HWB-hub/UAV-Air-Drop-System/media/photos/微信图片_20261011125443_73_13.jpg

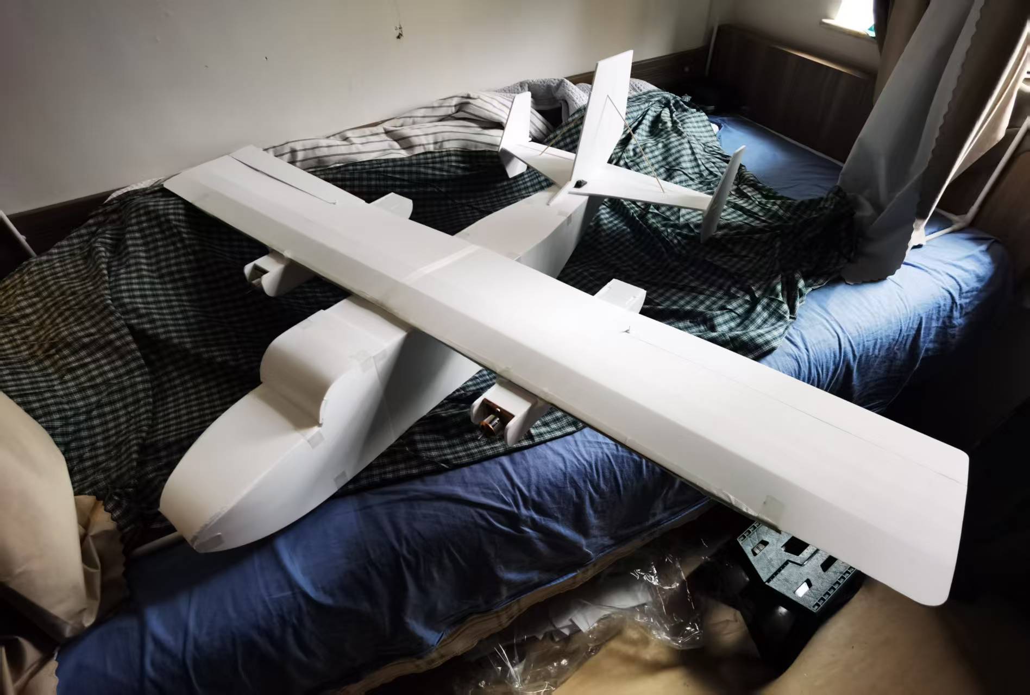
media/photos/微信图片_20261011125443_73_13.jpg
