HWB-hub/UAV-Air-Drop-System/README.md

**简体中文** | [English](README.en.md)

# 两轮卫星车投放与回收系统

**Two-Wheeled Rover Deployment & Recovery System**

一套完整的 **投放 → 伞降 → 回收 → 落地继续作业** 演示系统：自制固定翼无人机把一台 3D 打印的
**两轮卫星车（Rover）** 带到约 50 m 高空投放；卫星车靠**舵机触发的降落伞**安全落地；
落地后还能用**蓝牙遥控行驶**，并持续回传温度、气压、姿态数据。

| | |
|---|---|
| **项目定位** | 在业余预算下模拟真实卫星「发射 → 部署 → 下降 → 回收 → 继续工作」的全流程 |
| **我们做了什么** | ① 两轮卫星车：结构设计 + 3D 打印 + 电路 + 固件 + 伞舱释放机构 ② 固定翼载机的机体、动力与飞控 ③ 全部地面 / 空中测试与数据分析 |
| **关键指标** | 伞舱释放机构成本约为电磁锁方案的 1/10（约 $2 vs $20）· 载荷比 1:4 · 投放横向精度 ±1.5 m · 重复投放零损坏 |
| **团队** | 黄文博 · 孔筱崧 · Alexander He Wu · 马天辰 |

---

## 目录

1. [这个系统是什么](#1-这个系统是什么)
2. [我们做了什么](#2-我们做了什么)
   - [2.1 卫星车 · 机械结构](#21-卫星车--机械结构)
   - [2.2 卫星车 · 伞舱释放机构（核心创新）](#22-卫星车--伞舱释放机构核心创新)
   - [2.3 卫星车 · 电路与硬件](#23-卫星车--电路与硬件)
   - [2.4 卫星车 · 固件与通信协议](#24-卫星车--固件与通信协议)
   - [2.5 无线方案迭代：为什么最终用蓝牙而不是 XBee](#25-无线方案迭代为什么最终用蓝牙而不是-xbee)
   - [2.6 固定翼载机](#26-固定翼载机)
   - [2.7 测试与实测数据](#27-测试与实测数据)
   - [2.8 遇到的问题与解决办法](#28-遇到的问题与解决办法)
   - [2.9 预算](#29-预算)
3. [仓库结构](#3-仓库结构)
4. [快速上手（怎么把卫星车跑起来）](#4-快速上手怎么把卫星车跑起来)
5. [许可与团队](#5-许可与团队)

---

## 1. 这个系统是什么

把它想成一个**缩小的卫星任务**：真实的卫星要由火箭送到轨道、在轨分离、再入并回收；我们用一架
固定翼无人机代替火箭、用一台两轮小车代替卫星载荷，把这条链路完整地做了一遍，并且**落地之后
载荷还能继续工作**。

整条任务链分四步：

```text
  +-------------+ 舵机开舱门（遥控器 6 通道）    +----------------------+
  |  固定翼载机  |                              |    卫星车从机腹弹出   |
  |  （无人机）  | ------------------------->   |     高度约 50 m      |
  +-------------+                              +-----------+----------+
                                                           |
                                                           |  弹出后继续前冲
                                                           v
                                   +----------------------------------------------+
                                   |           伞舱释放（舵机 + 铁杆插销）          |
                                   |          铁杆抽出 -> 尼龙绳脱开 -> 开伞        |
                                   +-----------------------+----------------------+
                                                           |
                                                           v
                                   +----------------------------------------------+
                                   |              稳定下降 -> 安全着陆             |
                                   |           （30 m / 1.5 m 投放试验）           |
                                   +-----------------------+----------------------+
                                                           |
                                                           v
                                   +----------------------------------------------+
                                   |    落地后：蓝牙 HC-05 遥控行驶（F/B/L/R/S）    |
                                   |    并持续回传 MPU6050 / DPS310 / LM35 数据    |
                                   +----------------------------------------------+
```

1. **挂载**：卫星车被固定在载机的舱内，随飞机爬升到投放高度。
2. **投放**：飞手拨动遥控器第 6 通道，舵机打开舱门，卫星车被抛出。
3. **下降**：伞舱释放机构触发（见 [2.2](#22-卫星车--伞舱释放机构核心创新)），降落伞张开，卫星车稳定落地。
4. **回收与作业**：着陆后卫星车测量环境参数，并可由蓝牙遥控行驶，完成「回收后继续执行任务」这一环。

## 2. 我们做了什么

### 2.1 卫星车 · 机械结构

车体在 **Autodesk Fusion 360** 中建模、**3D 打印**成型。最终材料为 **PETG**，填充率 **30%**
（早期原型用陶瓷树脂、层高 0.3 mm；早期投放试验出现开裂后，改用 PETG 并把填充率提到 30% 以吸收冲击）。

打印壳体的几个设计要点：

* **两侧轮舱**按 N20 电机的轴距设计，并留出电机驱动与电池的**散热通风孔**。
* **传感器凹槽**按 **±0.2 mm** 公差开槽固定 MPU6050 与 DPS310，保证不同批次装配后测量轴一致。
* **舵机支架**竖直安装在壳体顶部，通过焊接铁杆连接到插销卡槽；静态测试中插销可拉住 **50 g** 后才脱开。
* **两个 40 mm 橡胶胎面车轮**，配合**差速（滑移）转向**，可爬 **15°** 坡、可原地转向，不需要转向舵机。
* **抗冲击**：结构通过 **10 次 1 m 自由落体**测试，壳体未开裂、传感器未位移；30 m / 1.5 m 伞降试验**零损坏**。
* 底部加一块**玻纤底板**增加刚度，并作为电路板与电池的安装面。

> 🖼️ 各元件的 Fusion 360 参考模型（Nano、MPU6050、车轮、N20 电机、电池、万用板、舵机、XBee、电机控制模块）
> 见 [`rover/cad/fusion360_components/`](rover/cad/fusion360_components/)。

### 2.2 卫星车 · 伞舱释放机构（核心创新）

这是整个卫星车最有特色的一块：**用一颗微型舵机 + 一根铁杆插销，替代了常见的电磁锁**，
把成本与电路复杂度几乎全部省掉。

```text
   降落伞尼龙绳（绳环）
           |
           v
  +-----------------+
  |    舵机摇臂     |   铁杆穿过绳环，
  |   (SG90, D3)    |--> 由自制卡槽固定住
  +--------+--------+
           |  舵机转过 90°（蓝牙发送 "U" 指令）
           v
  +-----------------+
  |   铁杆被抽回    |--> 绳环脱开，降落伞自由
  +-----------------+
           |  相对气流 / 卫星车惯性把伞带出
           v
        降落伞张开
```

工作过程：

1. 一根**系留铁杆**固定在 SG90 舵机摇臂上，并由一块自制卡槽锁住；铁杆**穿过降落伞尼龙绳上的绳环**，
   把折叠好的降落伞**扣住**。
2. 需要开伞时，Arduino 让舵机转过 **90°**（蓝牙发 `U`），摇臂旋转、**铁杆从绳环中抽出**。
3. 降落伞此时已自由，卫星车继续飞行，伞被**相对气流 / 惯性**拉出并充气张开——
   不需要火工品、不需要弹簧、不需要额外执行器。

选这个方案的理由：

| 指标 | 电磁锁方案 | 舵机 + 铁杆（本项目） |
|---|---|---|
| 器件成本 | 约 $20 | **约 $2（降低约 90%）** |
| 需要额外电路 | 驱动电路 + 锁扣线圈 | 不需要，一颗普通舵机、直接接 Arduino |
| 可靠性（试验） | — | 30 m / 1.5 m 投放试验约 98% 成功开伞 |
| 失效表现 | 卡扣卡死 / 线圈过热 | 舵机堵转 → 复位即可；伞始终被扣住（偏安全） |

### 2.3 卫星车 · 电路与硬件

主控是 **Arduino Nano（ATmega328P）**。两个 **N20 减速电机**由 **TB6612FNG 双 H 桥**驱动，
两路驱动分别接到 **4 个数字口**（IN1/IN2 + IN3/IN4），因此左右轮可各自正反转，实现差速转向。
电机供电直接从 **7.4 V（2S）锂聚合物电池**取，避免大电流干扰逻辑电源。

最终固件（`rover_hc05_bluetooth_FINAL`）的接线：

| 功能 | 引脚 | 说明 |
|---|---|---|
| 电机 A（左）IN1 / IN2 | **D4 / D5** | 接 TB6612FNG Motor A |
| 电机 B（右）IN3 / IN4 | **D6 / D8** | 接 TB6612FNG Motor B |
| 降落伞 SG90 舵机（信号） | **D3** | PWM，0° → 90° 即释放 |
| LM35DZ（模拟温度） | **A2** | 10 mV/°C，`V = 采样值×5/1023`，`T = V×100` |
| MPU6050（I²C） | **A4 (SDA) / A5 (SCL)** | 地址 `0x68`，原始值 /16384（加速度）、/131（陀螺仪） |
| DPS310 气压计 | **SPI，CS = D10** | `dps.begin_SPI(10)`（Adafruit_DPS310） |
| HC-05 蓝牙 | **D0 (RX) / D1 (TX)** | 硬件串口，9600 波特率 |
| 串口调试 | USB | 同一路 9600 串口输出 |

**电源可行性估算（电子部分最坏情况电流预算）：**

| 器件 | 电流 |
|---|---|
| MPU6050 | 5 mA |
| BMP280 | 5 mA |
| LM35DZ | 5 mA |
| XBee-PRO S1 | 50 mA |
| TB6612FNG | 10 mA |
| Arduino Nano | 50 mA |
| N20 减速电机 ×2 | 各 150 mA |
| **合计** | **约 475 mA** |

这个估算确认了 7.4 V（2S）锂电池 + 5 V 稳压足以稳定供给整块电路板。

### 2.4 卫星车 · 固件与通信协议

全部 Arduino 代码在 [`rover/firmware/`](rover/firmware/)。每个文件夹都是一个**独立的 Arduino
工程**：用 Arduino IDE 打开 `.ino`，板子选 **Arduino Nano / ATmega328P**，通过 USB 下载即可。

| 工程 | 状态 | 通信方式 | 说明 |
|---|---|---|---|
| `rover_hc05_bluetooth_FINAL` | ✅ **最终版，现场投放使用的就是它** | HC-05 蓝牙，硬件串口 D0/D1 | 传感器采集 + 遥测输出 + 电机控制 + 伞舱舵机指令 |
| `xbee_rover_enddevice_swserial` | ⚙️ 早期（XBee） | XBee 接软串口 D2/D3 | 卫星车作为 XBee 终端节点，数据经电台转发 |
| `xbee_rover_enddevice_hwserial` | ⚙️ 早期（XBee） | XBee 接硬件串口 | 终端节点变体（增加了打印 NaN 的保护） |
| `xbee_ground_coordinator` | ⚙️ 早期（XBee） | XBee 接软串口 D2/D3 | 地面站协调器：接收遥测、把键盘指令转发给卫星车 |
| `xbee_ground_coordinator_dev` | ⚙️ 开发迭代 | 同上 | 协调器变体（转发前会去掉 CR/LF） |
| `component_tests/*` | 🧪 元件测试 | USB 串口 | BMP280 / DPS310 / LM35DZ / MPU6050 单器件测试程序 |

**遥测帧**（约每秒 1 帧，从 HC-05 串口 / USB 输出，9600 波特率）：

```text
T:<°C>,P:<hPa>,AX:<g>,AY:<g>,AZ:<g>,GX:<°/s>,GY:<°/s>,GZ:<°/s>,MPU Temp:<°C>
```

**行驶 / 开伞指令**——卫星车在 `handleCommand()` 里读取**单个 ASCII 字符**，
用任意蓝牙串口 App 连上 HC-05 即可发送：

| 字符 | 效果（最终固件） |
|---|---|
| `F` | 前进 —— 两个电机同向驱动 |
| `B` | 后退 —— 两个电机反向驱动 |
| `L` | 原地左转 —— 左轮反转、右轮正转 |
| `R` | 原地右转 —— 左轮正转、右轮反转 |
| `S` | 两轮停转，同时把伞舱舵机归位到 0° |
| `U` | 舵机转到 90° → **释放降落伞** |

### 2.5 无线方案迭代：为什么最终用蓝牙而不是 XBee

第一版无线方案用的是 **XBee-PRO S1** 数传电台（配一块地面协调器板），但实测中 XBee 节点
**在休眠/唤醒时不稳定**，而且在现场测试里**会丢接收到的射频数据**，于是换成了 **蓝牙 HC-05**
（手机直接配对，不再需要单独的地面协调器硬件）。

| | XBee 方案（早期） | 蓝牙方案（最终） |
|---|---|---|
| 无线模块 | **XBee-PRO S1** ↔ 地面协调器 | **HC-05** ↔ 手机串口 App |
| 气压计 | **BMP280** | **DPS310**（精度更高） |
| 现场表现 | ❌ 休眠/唤醒不稳定，测试中丢射频数据 | ✅ 稳定，指令延迟 < 0.5 s |
| 地面站 | 需要单独的协调器板 + 电脑 | 不需要，手机直接配对 |

### 2.6 固定翼载机

载机是一架自制固定翼飞机：机体用 **PP（魔术）板**激光切割成型、电子胶粘接，机翼与机身用
**碳纤维杆**加强，控制连杆为钢丝推杆。动力与航电部分：

| 部件 | 规格 / 作用 |
|---|---|
| **A2212 KV1400** 无刷电机 | 2–3S，约 47 g，3.17 mm 轴 |
| **40 A 电调 ×2** | 双发动力、差速推力 |
| **4S 2200 mAh 45C 锂电池** | 主电源 |
| **RF209S 九通道接收机** | PWM / PPM / S.BUS 输出 |
| **舵机 ×7** | 副翼（2）、升降舵、方向舵、舱门等 |
| **PID 飞控** | 电脑端预调参，提供增稳辅助 |

投放任务用到的接收机通道映射：

| 通道 | 用途 |
|---|---|
| Ch1 | 副翼舵机 ×2（并联） |
| Ch2 | 升降舵 |
| Ch3 & Ch5 | 双电调（差速推力） |
| Ch4 | 方向舵 |
| **Ch6** | **舱门 —— 投放卫星车** |
| **Ch9** | PID 飞控开关 |

飞手拨动 Ch6 打开舱门，卫星车在约 50 m 高度被投放，随后进入伞降回收流程。

### 2.7 测试与实测数据

* **投放 / 回收**：30 m 与 1.5 m 两种投放试验，开伞可靠（约 98%），PETG 壳体无破损，重复投放**零损坏**。
* **投放精度**：从约 50 m 高度投放，横向落点精度 **±1.5 m**；载机载荷比 **1:4**。
* **传感器**：
  * MPU6050：加速度 ±2 g（±0.05 g）、陀螺仪 ±250 °/s（±3%）；现场数据里开伞瞬间 Z 轴加速度约变化 1.5 g。
  * DPS310：量程 300–1200 hPa（±1 hPa），标定的高度误差 **±1.5 m**（融合后约 ±1.2 m）；地面输出稳定在约 1011 hPa。
  * LM35DZ：现场实测稳定工作在 −10 … +40 °C 区间。
* **通信**：HC-05 指令延迟 **< 0.5 s**（实测约 0.3 s 内响应），卫星车 ↔ 地面站链路端到端验证通过。

### 2.8 遇到的问题与解决办法

| 问题 | 根本原因 | 解决办法 |
|---|---|---|
| 蓝牙信号丢失 | 电机线缆的电磁干扰 | 电机线加屏蔽 + HC-05 上套磁环 |
| 低温下传感器数据漂移 | LM35 噪声 | LM35 输出端并联 0.1 µF 电容 |
| 壳体开裂 | 3D 打印层间结合强度不足 | 填充率提到 30% + 换 PETG 材料 |
| 电池过热 | 持续大电流 | 加散热片 + 壳体开散热孔 |
| DPS310 测量误差 | 气压标定漂移 | 对气压做实时（类卡尔曼）滤波 |

### 2.9 预算

**预算（合计约 ¥798）：**

| 卫星车电子与结构 | 价格（¥） | 载机部分 | 价格（¥） |
|---|---|---|---|
| XBee-PRO（初版方案） | 150 | 飞控板 | 100 |
| MPU6050 | 15 | 无刷电机 | 80 |
| BMP280 | 5 | 电调 ×2 | 100 |
| LM35DZ | 3 | 舵机 ×7 | 35 |
| N20 减速电机 ×2 | 15 | 2600 mAh 电池 | 100 |
| 328PB 电路板 | 25 | 机壳 | 50 |
| 玻纤底板 | 25 | — | — |
| 电池 | 15 | — | — |
| 3D 打印耗材 | 40 | — | — |
| 降落伞材料 | 40 | — | — |
| 购买舵机 | 5 | — | — |

设备租用与测试场地免费。（XBee 后来换成了 HC-05，见 [2.5](#25-无线方案迭代为什么最终用蓝牙而不是-xbee)。）

## 3. 仓库结构

```text
.
├── README.md                  ← 中文说明（本文件）
├── README.en.md               English version
├── LICENSE                    MIT 许可证
├── data/
│   └── launch_day/            发射当天的完整遥测日志（.xlsx，1517 条样本 / 约 120 s）
├── media/                     ← 照片与视频（卫星车和载机不再分开，统一放这里）
│   ├── photos/
│   └── videos/
├── rover/                     ← 两轮卫星车
│   ├── firmware/              Arduino 代码：最终蓝牙固件 + XBee 时期的车端 / 地面站代码
│   │   ├── rover_hc05_bluetooth_FINAL/     ✅ 现场投放使用的最终固件
│   │   ├── xbee_rover_enddevice_*/         ⚙️ 早期 XBee 车端
│   │   ├── xbee_ground_coordinator*/       ⚙️ 早期 XBee 地面站
│   │   └── component_tests/                🧪 BMP280 / DPS310 / LM35DZ / MPU6050 单器件测试
│   └── cad/fusion360_components/           各元件的 Fusion 360 参考模型
└── fixed_wing_aircraft/       ← 固定翼载机
    ├── cad_models/            机体 CAD / 结构图纸
    ├── docs/                  接线、通道映射等文档
    └── firmware_flight_controller/   飞控固件与调参配置
```

## 4. 快速上手（怎么把卫星车跑起来）

**下载并运行最终固件：**

1. 用 Arduino IDE 打开 `rover/firmware/rover_hc05_bluetooth_FINAL/rover_hc05_bluetooth_FINAL.ino`。
2. 安装库：**Adafruit DPS310**、**Adafruit Unified Sensor**；`Servo`、`Wire`、`SPI` 为自带库。
   （若你要回到早期的 BMP280 测试，再装 `Adafruit BMP280`。）
3. 板子选 **Arduino Nano**，处理器 ATmega328P，下载器选 AVRISP mkII / USB。
4. 按 [2.3](#23-卫星车--电路与硬件) 的表格接线，下载程序，打开串口监视器（**9600 波特率**），
   应当看到约 1 Hz 的遥测数据流。
5. 电机电源接 **7.4 V（2S）锂电池**，逻辑电源用 USB / 5 V 稳压。
6. 用手机上的蓝牙串口 App 连接 HC-05，发送 `F` / `B` / `L` / `R` / `S` / `U` 字符即可驱动小车与开伞。

> ⚠️ **注意安全**：`U` 会触发开伞，台架测试时请先**不挂降落伞、空载测试舵机**；
> 上电状态下请远离旋转的车轮与被弹出的铁杆。

## 5. 许可与团队

MIT 许可证，见 [`LICENSE`](LICENSE)。

**团队**：黄文博 · 孔筱崧 · Alexander He Wu · 马天辰

*“Deploy. Recover. Innovate.”*
