HWB-hub/UAV-Air-Drop-System/media/photos/微信图片_20261011125436_71_13.jpg

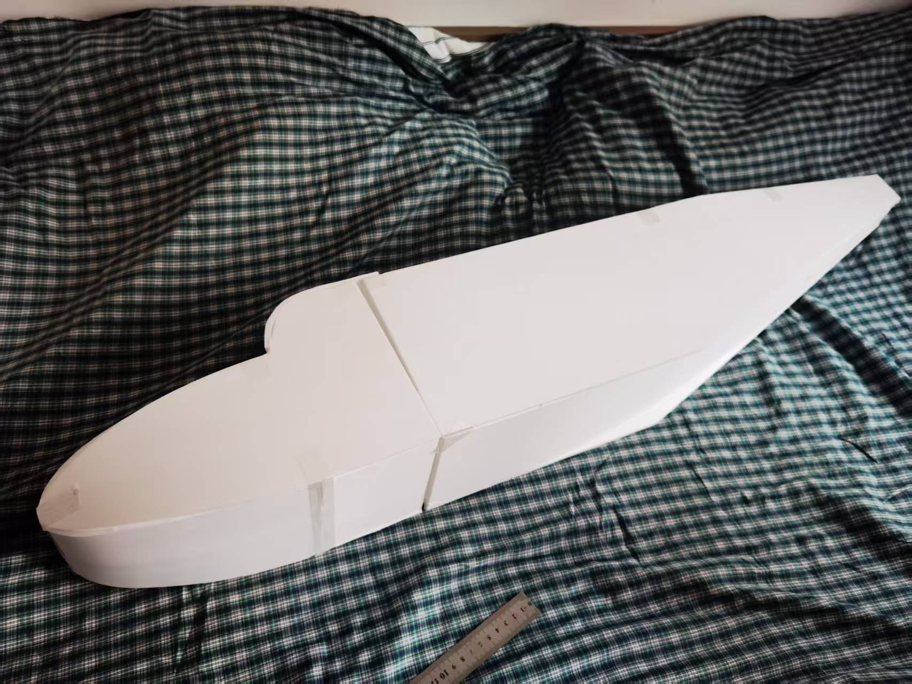
media/photos/微信图片_20261011125436_71_13.jpg
