HWB-hub/UAV-Air-Drop-System/(list of files, cad)

Other CAD files:
rover/cad/fusion360_components/9V电池 v1.f3d
rover/cad/fusion360_components/9_15万用板 v3.f3d
rover/cad/fusion360_components/BMP280 v2.f3d
rover/cad/fusion360_components/Cansat 轮子 v5.f3d
rover/cad/fusion360_components/LM35DZ v1.f3d
rover/cad/fusion360_components/MPU6050 v1.f3d
rover/cad/fusion360_components/N20减速电机 v2.f3d
rover/cad/fusion360_components/Xbee.f3d
rover/cad/fusion360_components/nano v1.f3d
rover/cad/fusion360_components/舵機 v1.f3d
rover/cad/fusion360_components/電機控製模塊.f3d
