HWB-hub/UAV-Air-Drop-System/(commit log)

2026-10-11 Add complete project files: bilingual README (zh/en), rover firmware and CAD, launch-day telemetry, fixed-wing aircraft structure
    [9V电池 v1.f3d, 9_15万用板 v3.f3d, BMP280 v2.f3d, Cansat 轮子 v5.f3d, LM35DZ v1.f3d, MPU6050 v1.f3d, N20减速电机 v2.f3d, Xbee.f3d]
2026-10-11 README: language switcher at the top (zh/en), Section 2.9 renamed to Budget
